zyue2022/RC_shipmodel/船模报告.pdf

电子科技园

## 一、摘要

我们小组制作的船模为虾艇，驱动部分使用无刷电机和无刷电调，舵机控制 转向；遥控器与接收器均基于 Arduino pro mini 制作，为 4 通道（可扩展），其 中遥控器（左手转向，右手油门）通过杜邦线连接，接收器为自行焊接；通信模 块使用的是 NRF24L01P+PA+LNA；使用了 AMS1117 3.3V 稳压芯片给通信模块提供 安全的电压；设置了滤波电容保证信号良好；接收机上设置了 LED 灯以表示是否 有信号；同时也对电机和电调设置了水冷保护。

## 二、部件选择

部件 | 型号 | 选择原因
电池 | 25c 2200mah 3s | 电压为11.2V，重量相对较小
电机 | 2440无刷 300W 4500KV | 相比同规格的2磁极电机发热更低 扭力更强低速线性更好更省电
舵机 | SG90 | 控制方向舵转向
电调 | 好盈海王40A 无刷 | 防水，高效散热，大电流
主控 | Arduino pro mini | 体积小，接线烧录方便
通信模块 | NRF24L01P+PA+LNA | 此2.4G 无线模块通信距离远，抗 干扰能力强，丢包率低
稳压模块 | AMS1117 3.3V | 给通信模块供电，保证电压稳定
操纵杆 | Joystick 模块 360度旋转 | 操作灵敏，收集4个通道的信号
电容 | 电解电容25V 100uF | 滤除通信模块供电电压信号中的

交流分量，以保证信号稳定 104电容

## 三、硬件框图

## (1)遥控器接线

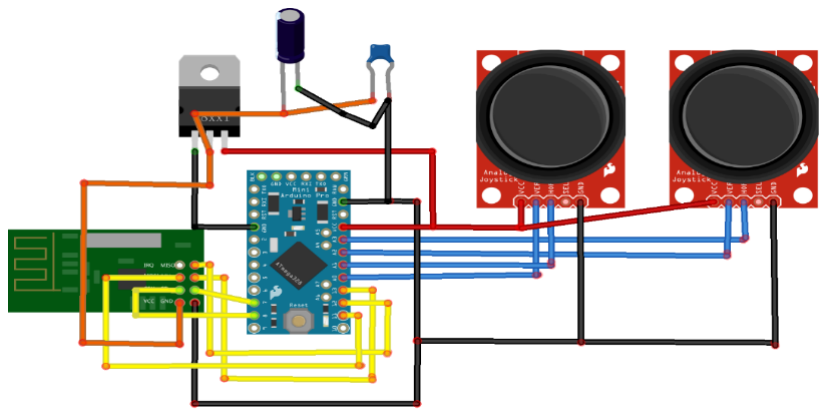
[picture p1: figure]

## (2)接收器及船内驱动装置接线

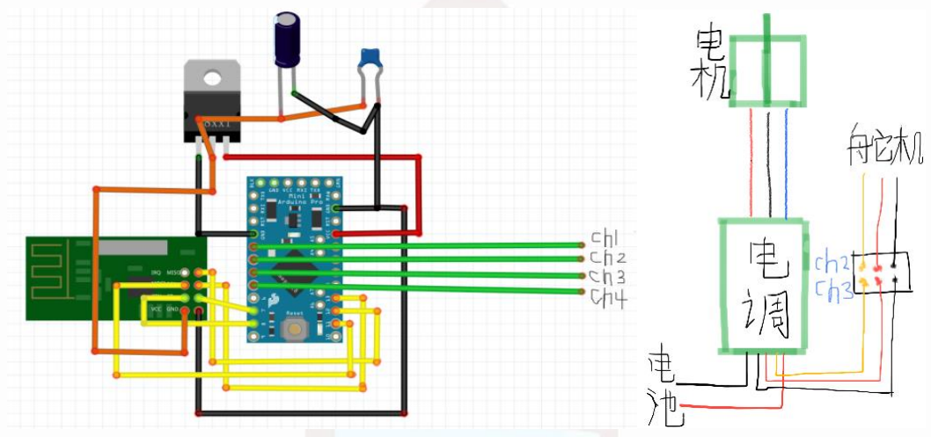
[picture p2: figure]

注：CH2接舵机、CH3接电调；使用 fritzing 绘制

## 四、软件流程

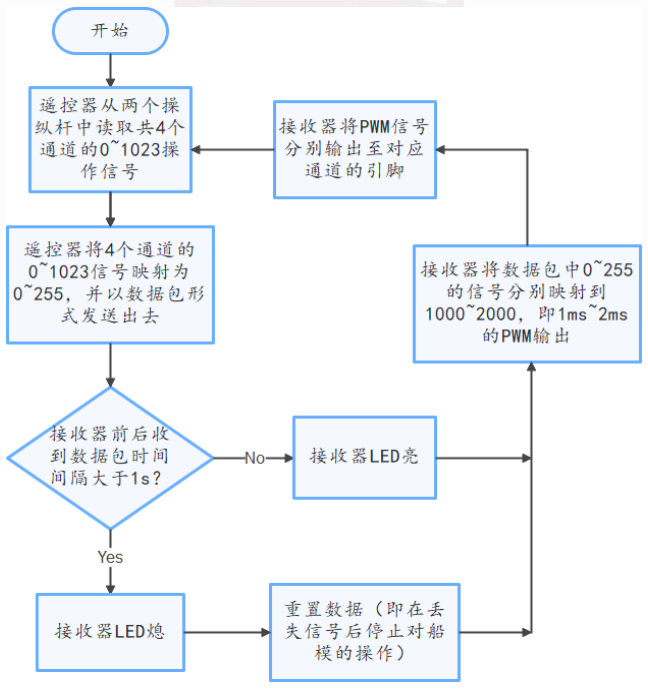
[picture p3: figure]

## 附录一 电路图

## (1)遥控器

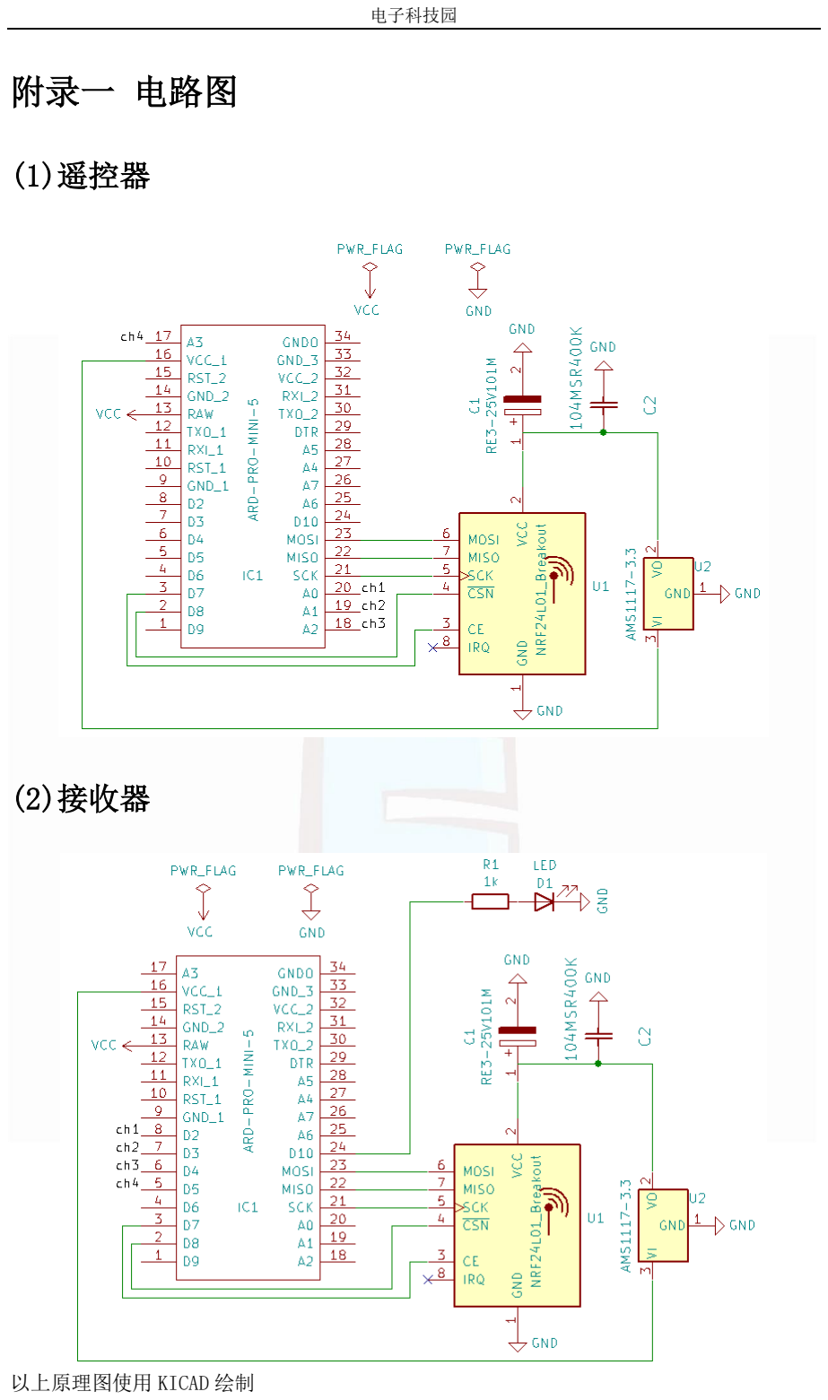
[picture p4: page 3]

## (2)接收器

以上原理图使用 KICAD 绘制

## 附录二 制作过程及实物展示

(1)船体

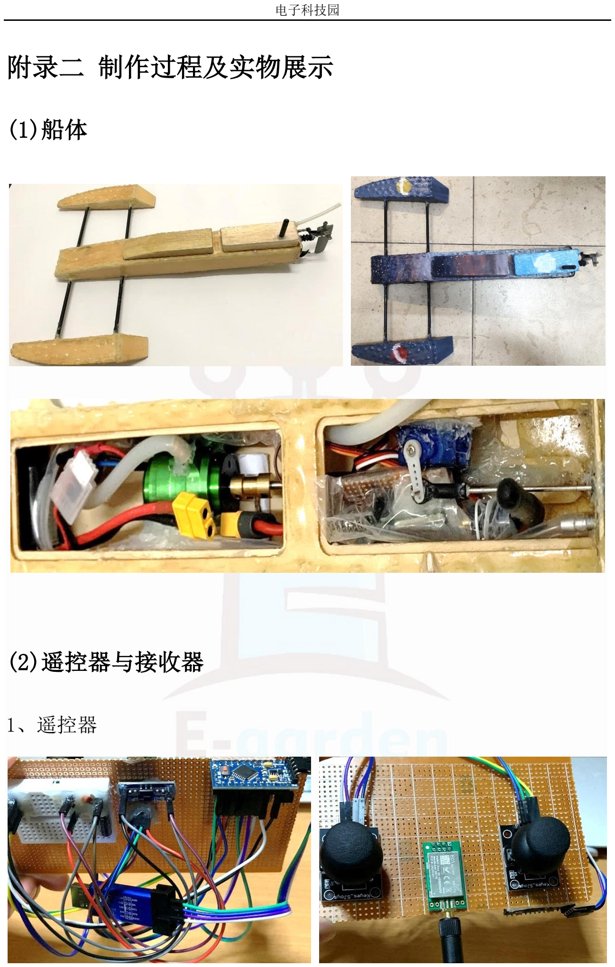
[picture p5: page 4]

## (2)遥控器与接收器

1、遥控器

2、接收器

模型图：

实物图：

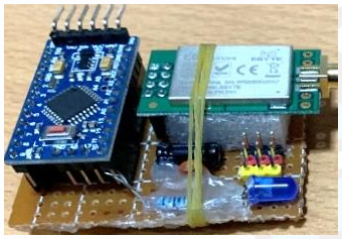
[picture p6: figure]

3、综合

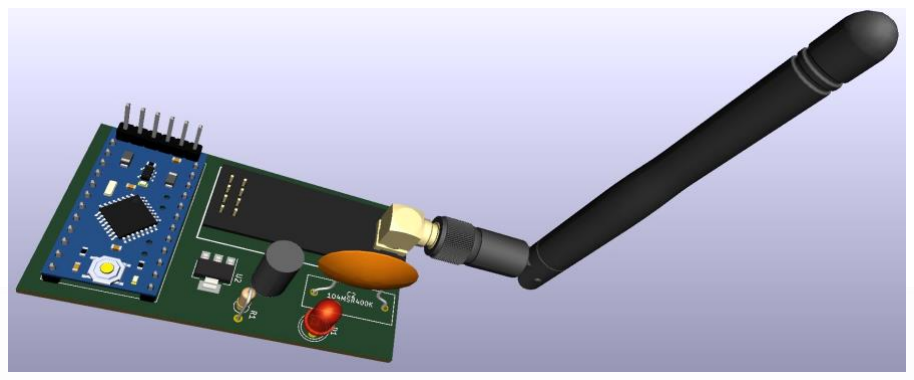
[picture p7: figure]
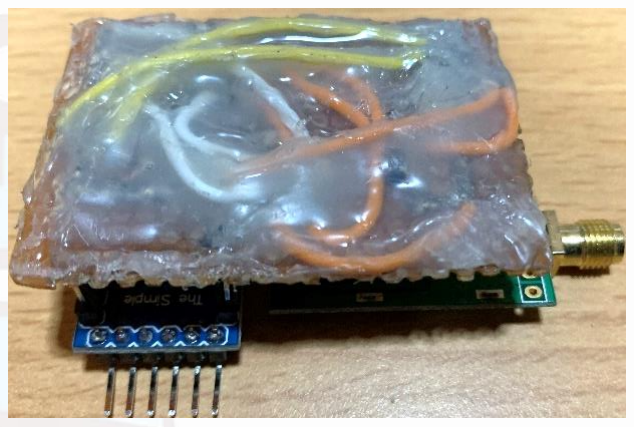
[picture p8: figure]
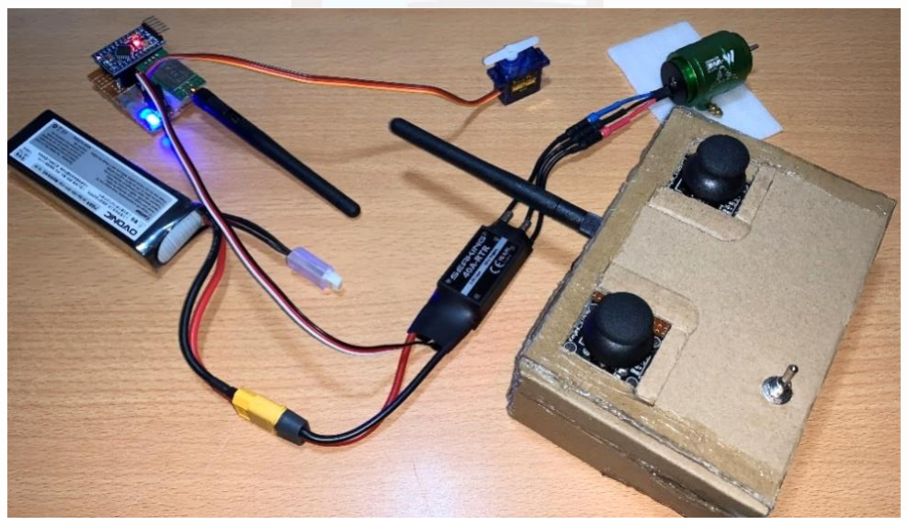
[picture p9: figure]

## 附录三 源代码

## (1)遥控器

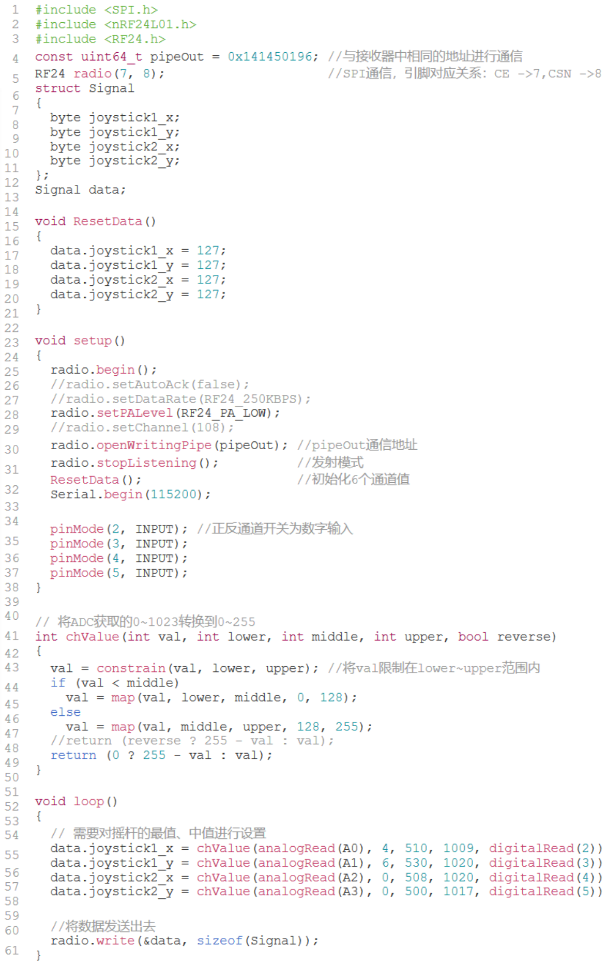
[picture p10: figure]

## (2)接收器

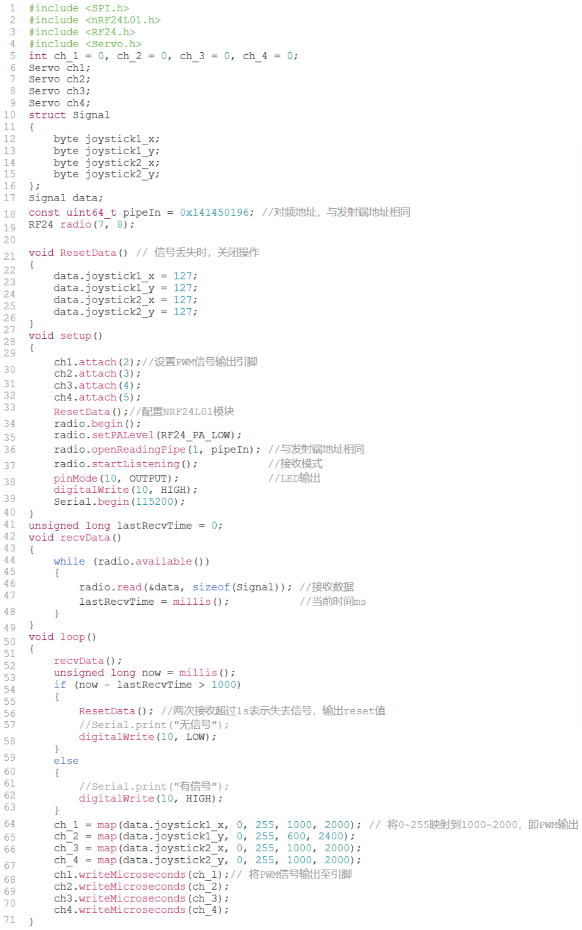
[picture p11: figure]

## 附录四 参考博客

① https://howtomechatronics.com/projects/diy-arduino-rc-transmitter/ ② https://howtomechatronics.com/projects/diy-arduino-rc-receiver/ ③ https://blog.csdn.net/weixin_42268054/article/details/105536264
